derlucas/freeDSP-CLASSIC/SOURCES/EAGLE/freeDSP.brd

## EAGLE design SOURCES/EAGLE/freeDSP.brd (2016-01-29)

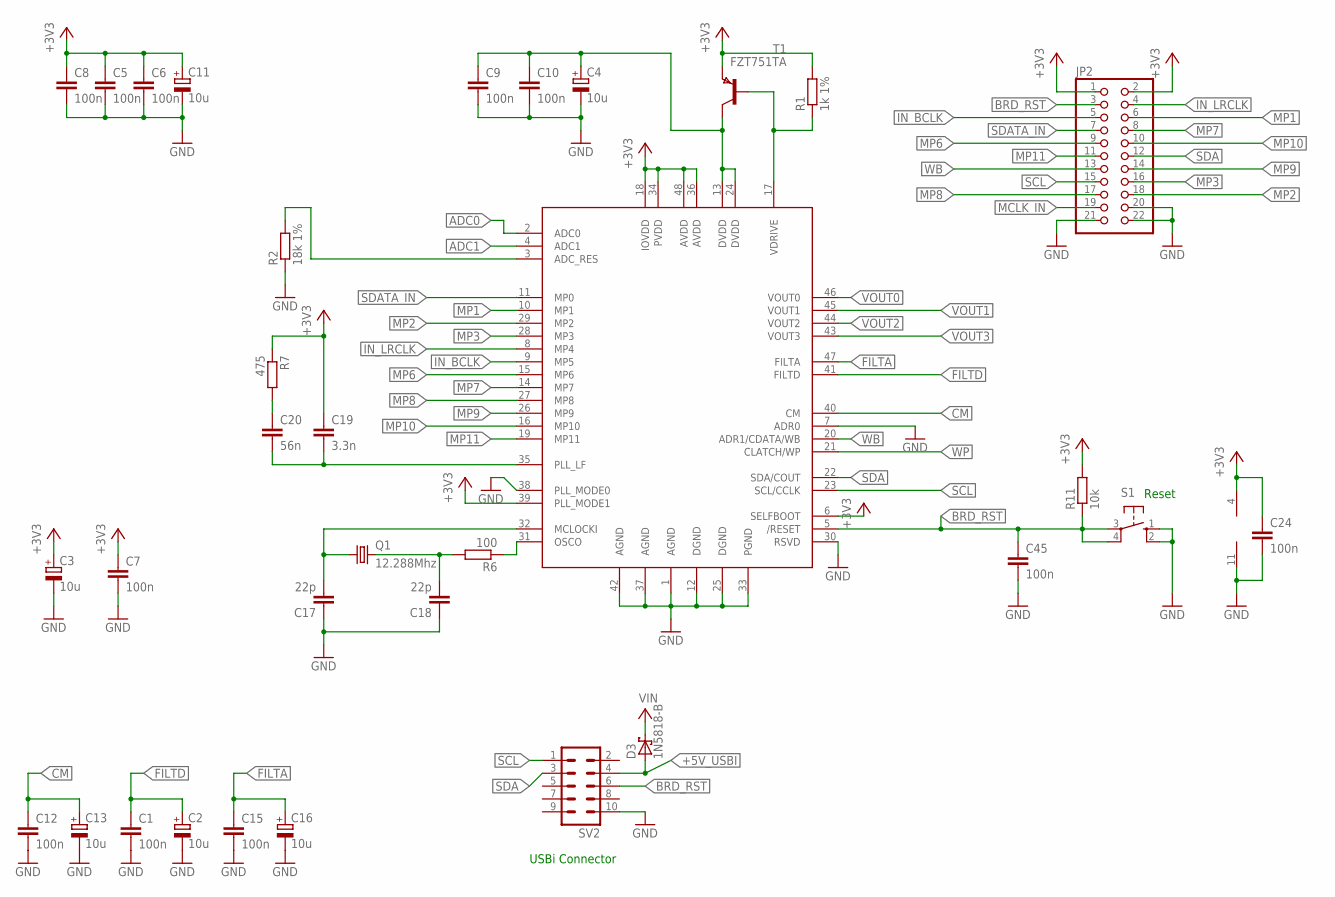
[picture p1: schematic freeDSP.sch, sheet 1]

Parts:
C1, C5, C6, C7, C8, C9, C10, C12, C15, C24, C45: 100n; C025-025X050
C2, C3, C4, C11, C13, C16: 10u; E1,8-4
C17, C18: 22p; C025-025X050
C19: 3.3n; C025-025X050
C20: 56n; C025-025X050
D3: 1N5818-B; DO41-7.6
IC3: AD8608R; SO-14
JP2: PINHD-2X11; 2X11
Q1: 12.288Mhz; HC49/S
R1: 1k 1%; 0207/10
R2: 18k 1%; 0207/10
R6: 100; 0207/10
R7: 475; 0207/10
R11: 10k; 0207/10
S1: 10-XX; B3F-10XX
SV2: ML10
T1: FZT751TA; SOT223
U$1: ADAU1701; LQFP-48

Connections:
1V8: C4.+, C9.1, C10.1, T1.2 (C), T1.4 (C), U$1.13 (DVDD), U$1.24 (DVDD)
+3V3: C3.+, C5.1, C6.1, C7.1, C8.1, C11.+, C19.1, C24.1, IC3.4 (V+), JP2.1, JP2.2, R1.2, R7.1, R11.2, T1.3 (E), U$1.6 (SELFBOOT), U$1.18 (IOVDD), U$1.34 (PVDD), U$1.36 (AVDD), U$1.39 (PLL_MODE1), U$1.48 (AVDD); also elsewhere on the board
+5V_USBI: D3.A, SV2.4
ADC0: U$1.2 (ADC0); also elsewhere on the board
ADC1: U$1.4 (ADC1); also elsewhere on the board
BRD_RST: C45.1, JP2.3, R11.1, S1.3, S1.4 (P1), SV2.6, U$1.5 (/RESET); also elsewhere on the board
CM: C12.1, C13.+, U$1.40 (CM)
FILTA: C15.1, C16.+, U$1.47 (FILTA)
FILTD: C1.1, C2.+, U$1.41 (FILTD)
GND: C1.2, C2.-, C3.-, C4.-, C5.2, C6.2, C7.2, C8.2, C9.2, C10.2, C11.-, C12.2, C13.-, C15.2, C16.-, C17.1, C18.1, C24.2, C45.2, IC3.11 (V-), JP2.20, JP2.21, JP2.22, R2.1, S1.1 (S), S1.2 (S1), SV2.10, U$1.1 (AGND), U$1.7 (ADR0), U$1.12 (DGND), U$1.25 (DGND), U$1.30 (RSVD), U$1.33 (PGND), U$1.37 (AGND), U$1.38 (PLL_MODE0), U$1.42 (AGND); also elsewhere on the board
IN_BCLK: JP2.5, U$1.9 (MP5)
IN_LRCLK: JP2.4, U$1.8 (MP4)
MCLK_IN: JP2.19
MP1: JP2.6, U$1.10 (MP1)
MP2: JP2.18, U$1.29 (MP2)
MP3: JP2.16, U$1.28 (MP3)
MP6: JP2.9, U$1.15 (MP6)
MP7: JP2.8, U$1.14 (MP7)
MP8: JP2.17, U$1.27 (MP8)
MP9: JP2.14, U$1.26 (MP9)
MP10: JP2.10, U$1.16 (MP10)
MP11: JP2.11, U$1.19 (MP11)
unnamed: R2.2, U$1.3 (ADC_RES)
unnamed: R1.1, T1.1 (B), U$1.17 (VDRIVE)
unnamed: C19.2, C20.2, U$1.35 (PLL_LF)
unnamed: C20.1, R7.2
unnamed: C18.2, Q1.2, R6.2
unnamed: R6.1, U$1.31 (OSCO)
unnamed: C17.2, Q1.1, U$1.32 (MCLOCKI)
SCL: JP2.15, SV2.1, U$1.23 (SCL/CCLK); also elsewhere on the board
SDA: JP2.12, SV2.3, U$1.22 (SDA/COUT); also elsewhere on the board
SDATA_IN: JP2.7, U$1.11 (MP0)
V+: D3.C; also elsewhere on the board
VOUT0: U$1.46 (VOUT0); also elsewhere on the board
VOUT1: U$1.45 (VOUT1); also elsewhere on the board
VOUT2: U$1.44 (VOUT2); also elsewhere on the board
VOUT3: U$1.43 (VOUT3); also elsewhere on the board
WB: JP2.13, U$1.20 (ADR1/CDATA/WB)
WP: U$1.21 (CLATCH/WP); also elsewhere on the board

Notes on the sheet:
Reset
USBi Connector

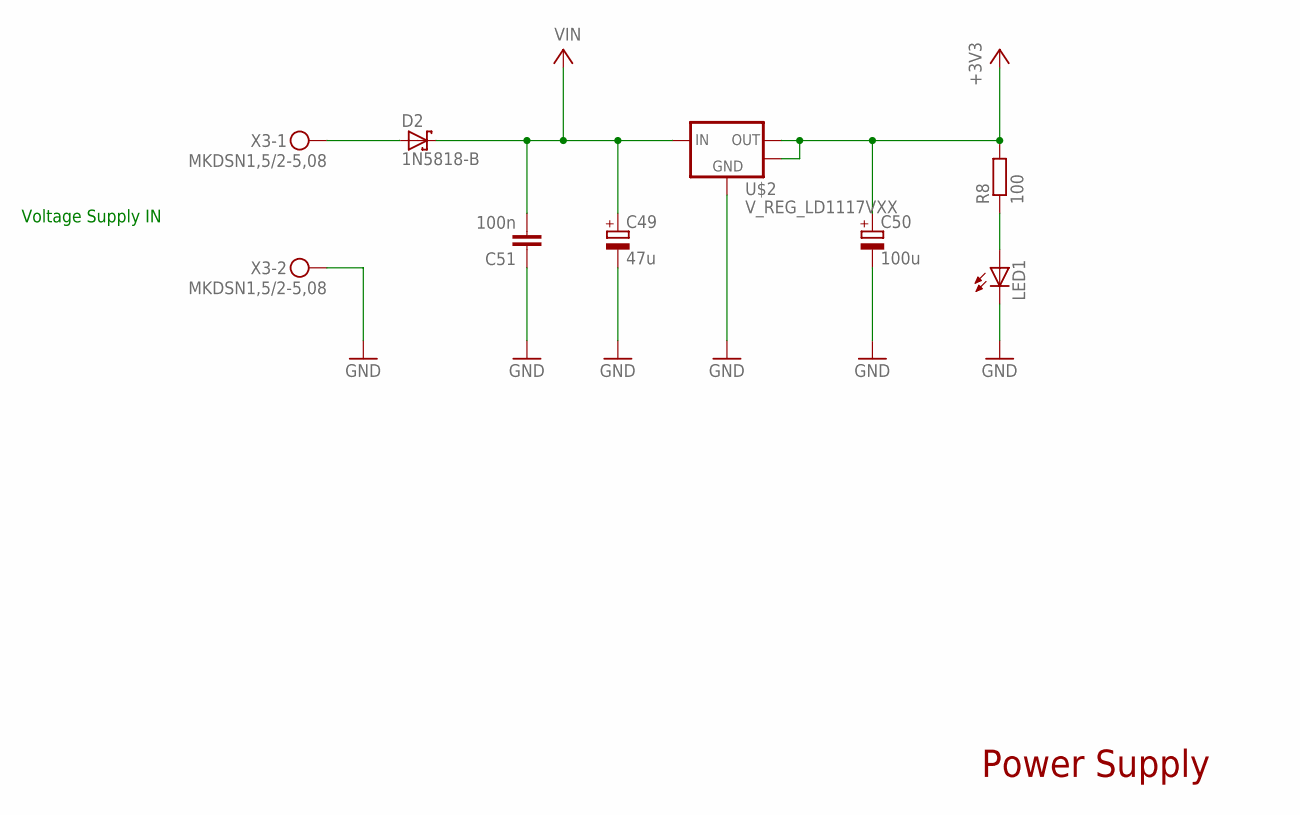
[picture p2: schematic freeDSP.sch, sheet 2]

Parts:
C49: 47u; E2,5-6
C50: 100u; E2,5-6
C51: 100n; C025-025X050
D2: 1N5818-B; DO41-7.6
LED1: LED3MM
R8: 100; 0207/10
U$2: V_REG_LD1117VXX; 78XXL
X3: MKDSN1,5/2-5,08

Connections:
+3V3: C50.+, R8.2, U$2.GND (OUT), U$2.OUT2; also elsewhere on the board
GND: C49.-, C50.-, C51.1, LED1.K (C), U$2.IN (GND), X3.2; also elsewhere on the board
unnamed: LED1.A, R8.1
unnamed: D2.A, X3.1
V+: C49.+, C51.2, D2.C, U$2.OUT (IN); also elsewhere on the board

Notes on the sheet:
Voltage Supply IN
Power Supply

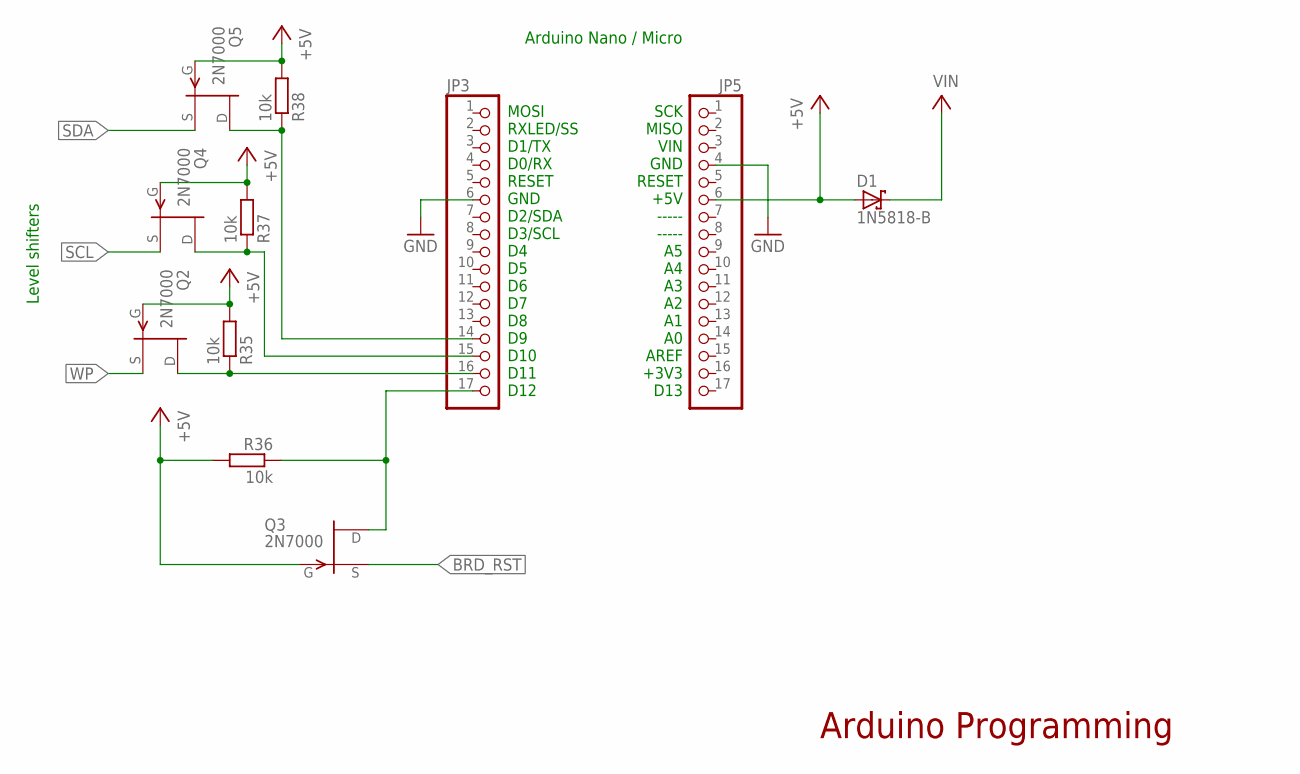
[picture p3: schematic freeDSP.sch, sheet 3]

Parts:
D1: 1N5818-B; DO41-7.6
JP3, JP5: PINHD-1X17; 1X17
Q2, Q3, Q4, Q5: 2N7000; TO92
R35, R36, R37, R38: 10k; 0207/10

Connections:
+5V: D1.A, JP5.6, Q2.2 (G), Q3.2 (G), Q4.2 (G), Q5.2 (G), R35.2, R36.2, R37.2, R38.2
BRD_RST: Q3.3 (S); also elsewhere on the board
GND: JP3.6, JP5.4; also elsewhere on the board
unnamed: JP3.15, Q4.1 (D), R37.1
unnamed: JP3.14, Q5.1 (D), R38.1
unnamed: JP3.16, Q2.1 (D), R35.1
unnamed: JP3.17, Q3.1 (D), R36.1
SCL: Q4.3 (S); also elsewhere on the board
SDA: Q5.3 (S); also elsewhere on the board
V+: D1.C; also elsewhere on the board
WP: Q2.3 (S); also elsewhere on the board

Notes on the sheet:
Arduino Programming
Arduino Nano / Micro
MOSI RXLED/SS D1/TX D0/RX RESET GND D2/SDA D3/SCL D4 D5 D6 D7 D8 D9 D10 D11 D12
SCK MISO VIN GND RESET +5V ----- ----- A5 A4 A3 A2 A1 A0 AREF +3V3 D13
Level shifters

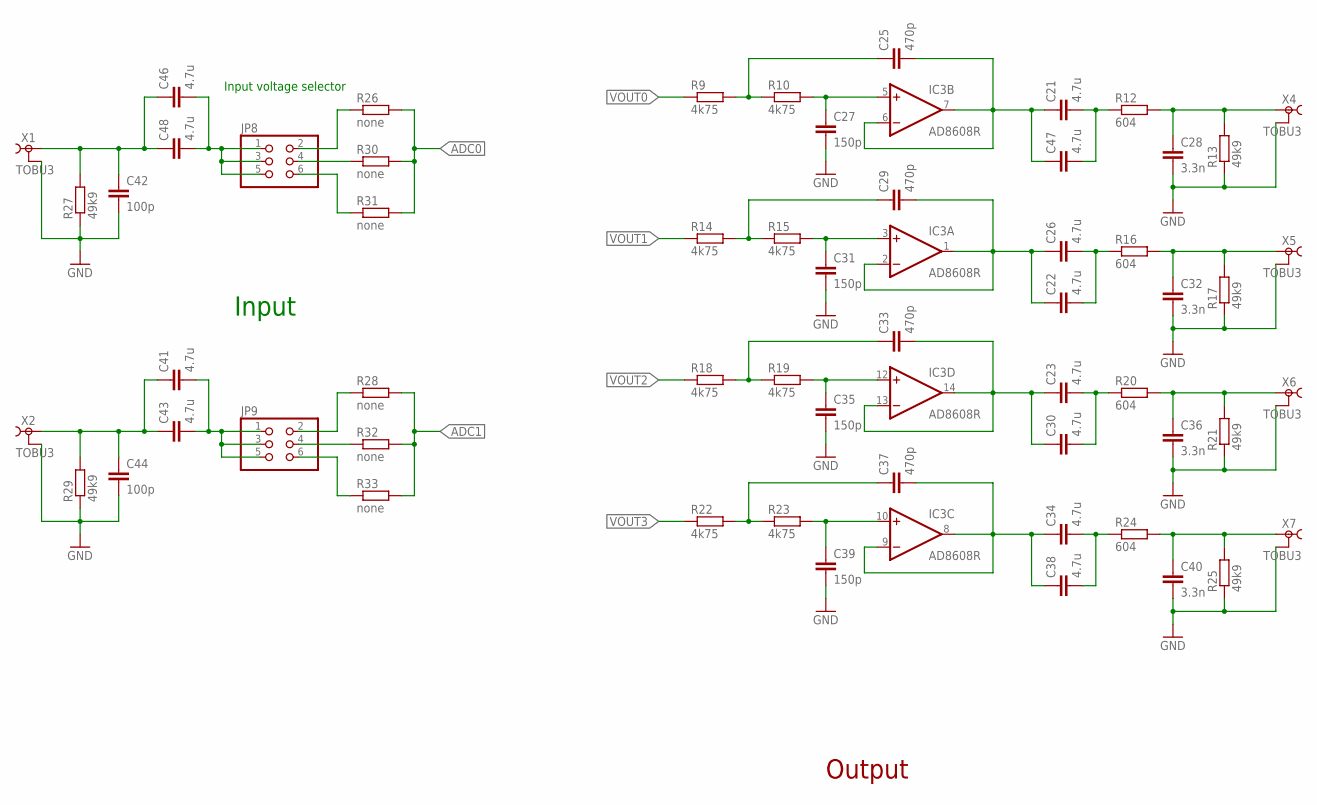
[picture p4: schematic freeDSP.sch, sheet 4]

Parts:
C21, C22, C23, C26, C30, C34, C38, C41, C43, C46, C47, C48: 4.7u; C050-075X075
C25, C29, C33, C37: 470p; C050-050X075
C27, C31, C35, C39: 150p; C025-025X050
C28, C32, C36, C40: 3.3n; C025-025X050
C42, C44: 100p; C025-025X050
IC3: AD8608R; SO-14
JP8, JP9: PINHD-2X3; 2X03
R9, R10, R14, R15, R18, R19, R22, R23: 4k75; 0207/10
R12, R16, R20, R24: 604; 0207/10
R13, R17, R21, R25, R27, R29: 49k9; 0207/10
R26, R28, R30, R31, R32, R33: none; 0207/10
X1, X2, X4, X5, X6, X7: TOBU3

Connections:
ADC0: R26.2, R30.2, R31.2; also elsewhere on the board
ADC1: R28.2, R32.2, R33.2; also elsewhere on the board
FILTOUT0: C28.1, R12.2, R13.2, X4.1
FILTOUT1: C32.1, R16.2, R17.2, X5.1
FILTOUT2: C36.1, R20.2, R21.2, X6.1
FILTOUT3: C40.1, R24.2, R25.2, X7.1
GND: C27.2, C28.2, C31.2, C32.2, C35.2, C36.2, C39.2, C40.2, C42.2, C44.2, R13.1, R17.1, R21.1, R25.1, R27.1, R29.1, X1.2, X1.2@1 (2), X1.2@2 (2), X2.2, X2.2@1 (2), X2.2@2 (2), X4.2, X4.2@1 (2), X4.2@2 (2), X5.2, X5.2@1 (2), X5.2@2 (2), X6.2, X6.2@1 (2), X6.2@2 (2), X7.2, X7.2@1 (2), X7.2@2 (2); also elsewhere on the board
unnamed: C23.1, C30.1, C33.2, IC3.13 (-IN), IC3.14 (OUT)
unnamed: C21.2, C47.2, R12.1
unnamed: C29.1, R14.2, R15.1
unnamed: C22.1, C26.1, C29.2, IC3.1 (OUT), IC3.2 (-IN)
unnamed: C31.1, IC3.3 (+IN), R15.2
unnamed: C25.1, R9.2, R10.1
unnamed: C21.1, C25.2, C47.1, IC3.6 (-IN), IC3.7 (OUT)
unnamed: C22.2, C26.2, R16.1
unnamed: C27.1, IC3.5 (+IN), R10.2
unnamed: C33.1, R18.2, R19.1
unnamed: C23.2, C30.2, R20.1
unnamed: C35.1, IC3.12 (+IN), R19.2
unnamed: C37.1, R22.2, R23.1
unnamed: C34.1, C37.2, C38.1, IC3.8 (OUT), IC3.9 (-IN)
unnamed: C39.1, IC3.10 (+IN), R23.2
unnamed: C34.2, C38.2, R24.1
unnamed: C46.2, C48.2, JP8.1, JP8.3, JP8.5
unnamed: C42.1, C46.1, C48.1, R27.2, X1.1
unnamed: JP8.2, R26.1
unnamed: JP8.4, R30.1
unnamed: C41.1, C43.1, C44.1, R29.2, X2.1
unnamed: JP8.6, R31.1
unnamed: C41.2, C43.2, JP9.1, JP9.3, JP9.5
unnamed: JP9.2, R28.1
unnamed: JP9.4, R32.1
unnamed: JP9.6, R33.1
VOUT0: R9.1; also elsewhere on the board
VOUT1: R14.1; also elsewhere on the board
VOUT2: R18.1; also elsewhere on the board
VOUT3: R22.1; also elsewhere on the board

Notes on the sheet:
Output
Input
Input voltage selector

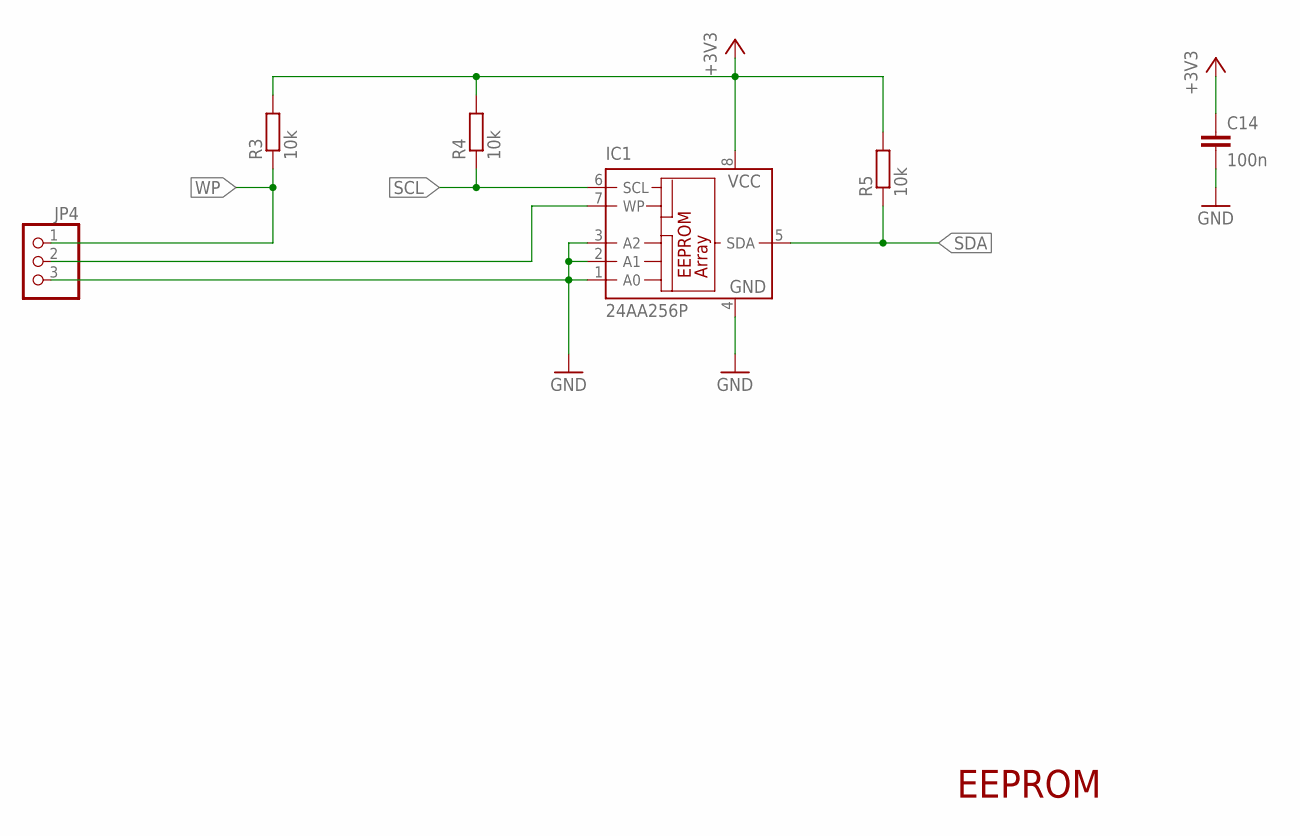
[picture p5: schematic freeDSP.sch, sheet 5]

Parts:
C14: 100n; C025-025X050
IC1: 24AA256P; DIL8
JP4: PINHD-1X3; 1X03
R3, R4, R5: 10k; 0207/10

Connections:
+3V3: C14.1, IC1.8 (VCC), R3.2, R4.2, R5.2; also elsewhere on the board
GND: C14.2, IC1.1 (A0), IC1.2 (A1), IC1.3 (A2), IC1.4 (GND), JP4.3; also elsewhere on the board
unnamed: IC1.7 (WP), JP4.2
SCL: IC1.6 (SCL), R4.1; also elsewhere on the board
SDA: IC1.5 (SDA), R5.1; also elsewhere on the board
WP: JP4.1, R3.1; also elsewhere on the board

Notes on the sheet:
EEPROM

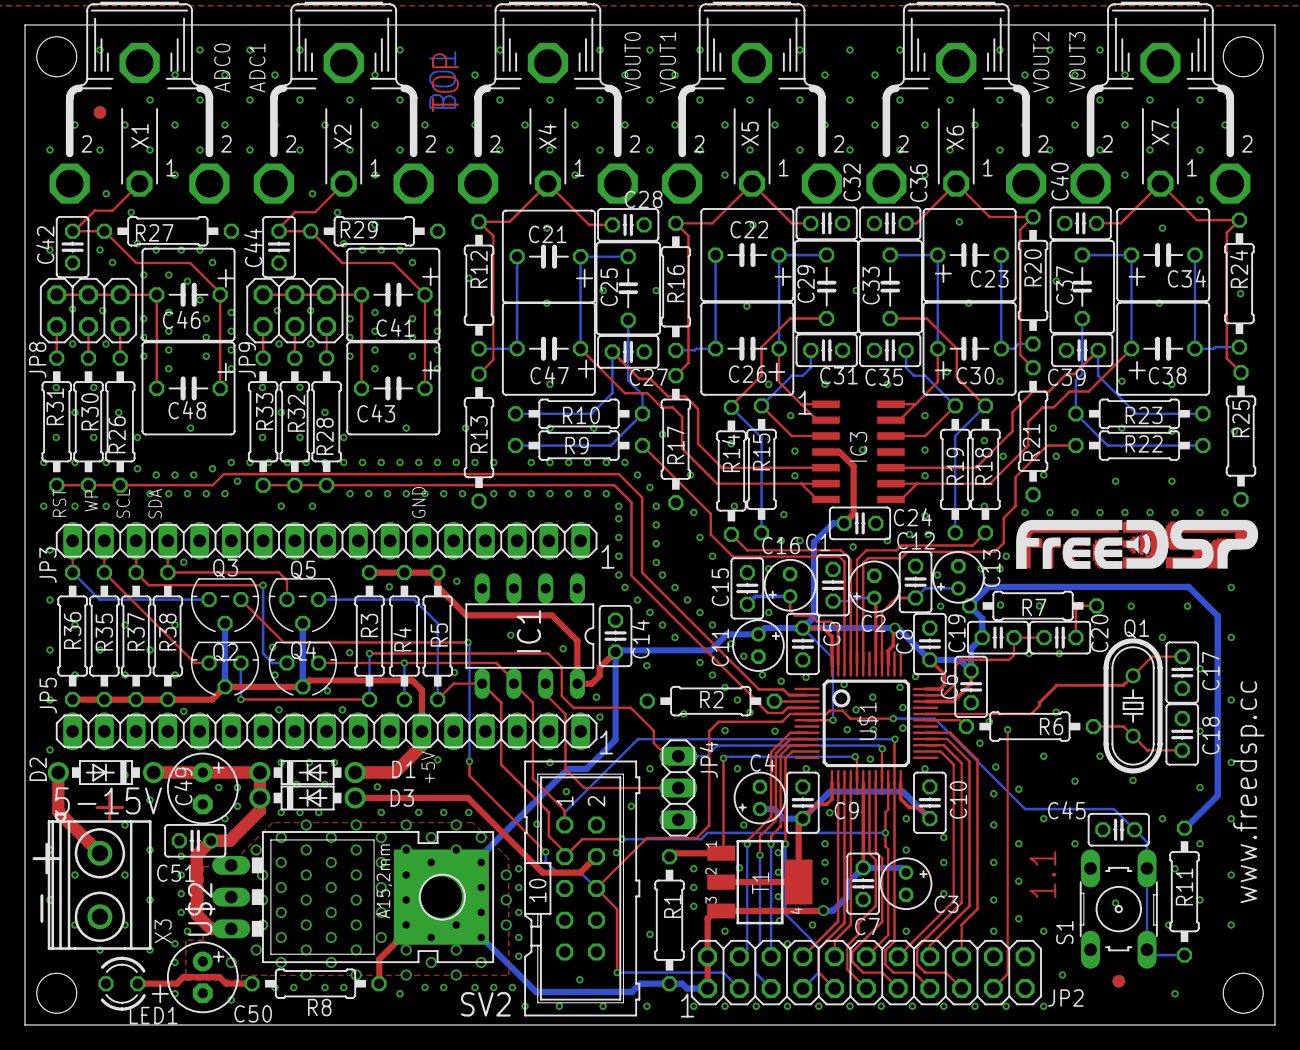
[picture p6: board freeDSP.brd from above]

Board: 2 copper layers, 100.0 x 80.0 mm, 119 parts (0 on the bottom side), 76 nets.

Other parts of the board:
U$3, U$4: VISION_REF10
