derlucas/freeDSP-CLASSIC/(commit log)

2016-01-29 cleaned up the schematic and moved parts to different sheets
    [freeDSP.brd, freeDSP.sch]
2016-01-29 cleaned up sheet 0 and edited ADAU1701 to be smaller in the schematic
    [freeDSP.brd, freeDSP.sch]
